Huyqngg/Logic_Analyzer_FPGA/hardware/bao_ve_io_1kenh.asc

A1: schmtinv; Vt=1.25 Vh=0.35 Vhigh=3.3 Vlow=0 Trise=3n Tfall=3n
C1: cap; 2.2p
Cin: cap; 5p
Cload: cap; 6p
D1: zener; DTVS
R1: res; 1Meg
Rdrv: res; 18
Rin1: res; 220
Rout1: res; 33
V1: voltage; PULSE(0 3.3 100n 5n 5n 495n 1000n)
Named nets: 0, in, prot, bufo, drv, fpga
.tran 0 5u 0 1n
.model DTVS D(BV=6.1 IBV=1m Cjo=0.5p Is=1e-12 Rs=0.5)
MACH BAO VE IO - 1 KENH (x16 kenh giong het nhau) - PHIEN BAN DUNG 74LVC14A
CHx -> Rin 220 -> [D1 = TPD4E05U06 kep xuong GND, mo hinh zener 6.1V] -> [R1 1M // C1 2.2p]
-> A1 = SN74LVC14A (Schmitt INVERTER @3.3V, VT+ = 1.6V, VT- = 0.9V, input chiu 5.5V)
-> Rdrv 18 (noi tro output IC) -> Rout 33 -> chan FPGA (Cload 6p)
LUU Y: chan FPGA nhan song bi DAO MUC (V(fpga) = NOT V(in)). FPGA tu dao lai bang
tham so INVERT_PROBE=1 trong logic_analyzer_top.v (NOT + NOT = tin hieu that).
Chua lap mach bao ve -> nap la_khong_dao.sof; da lap -> nap la_co_dao.sof.
V1 mac dinh: clock 1MHz 3.3V. Doi V1 de thu cac ca khac (5V DC, -5V, xung 12V...)
