Huyqngg/Logic_Analyzer_FPGA/hardware/bao_ve_io_testbench.asc

A1: schmtinv; Vt=1.25 Vh=0.35 Vhigh=3.3 Vlow=0 Trise=3n Tfall=3n
C1: cap; 2.2p
Cin: cap; 5p
Cload: cap; 6p
D1: zener; DTVS
R1: res; 1Meg
Rdrv: res; 18
Rin1: res; 220
Rout1: res; 33
V1: voltage; PULSE(0 {VAMP} 100n 5n 5n 495n 1000n)
Named nets: 0, in, prot, bufo, drv, fpga
.tran 0 5u 0 1n
.model DTVS D(BV=6.1 IBV=1m Cjo=0.5p Is=1e-12 Rs=0.5)
.step param VAMP list 1.2 1.8 2.5 3.3 5
TESTBENCH (74LVC14A - INVERTER): quet bien do 1.2V / 1.8V / 2.5V / 3.3V / 5V (clock 1MHz)
Bam Run roi ve V(in), V(prot), V(fpga): V(fpga) la song DAO cua V(in) - FPGA se tu dao
lai bang INVERT_PROBE=1. Nguong Schmitt VT+ = 1.6V quyet dinh muc logic nao duoc nhan
(>=2.5V OK; 1.8V bien; 1.2V KHONG qua nguong -> fpga giu muc cao co dinh = idle sau dao).
5V: V(prot) van ~5V (input LVC chiu 5.5V) va fpga ra 0/3.3V chuan -> AN TOAN.
